MidnightLink/esphome-projects/README.md

This repo is for changes done to the Velux controller. USB-C has been added in place of the barrel plug
