MidnightLink/esphome-projects/velux-controller/pcb/velux-controller.kicad_pcb

## KiCad design velux-controller/pcb/velux-controller.kicad_pcb (2025-07-20)

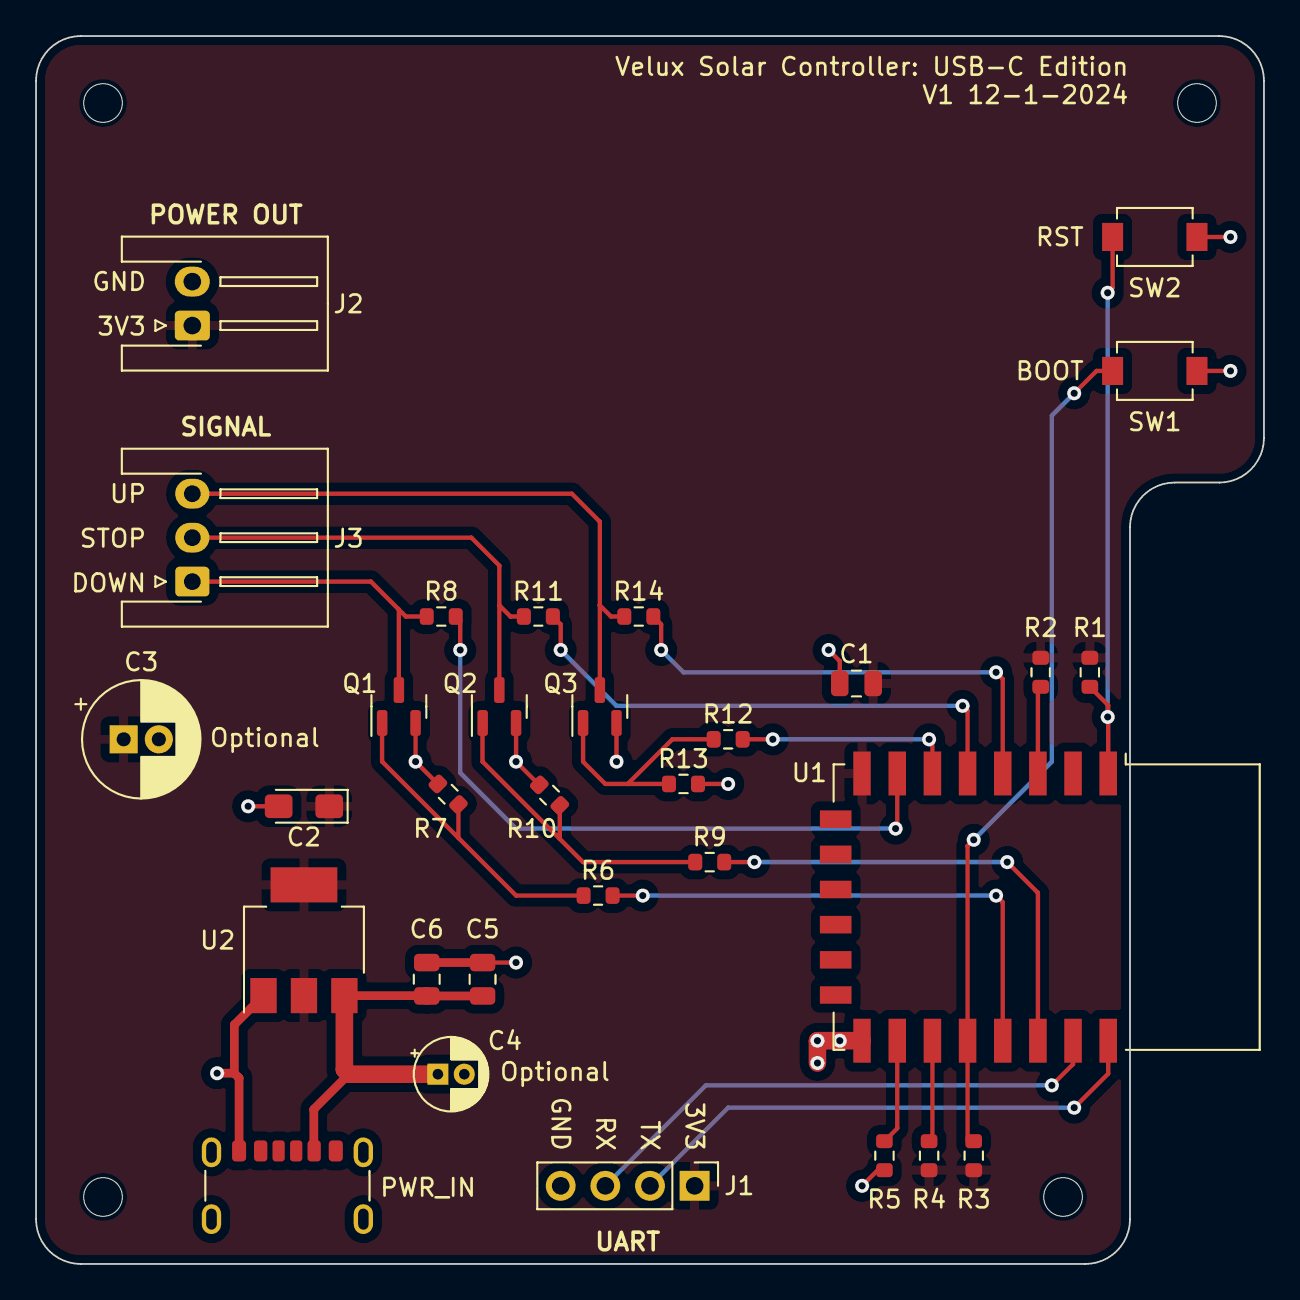
[picture p1: board velux-controller.kicad_pcb from above]

Board: 2 copper layers, 69.9 x 69.8 mm, 35 parts (0 on the bottom side), 22 nets.

Parts:
C1, C6: 0.1μF; C_0805_2012Metric
C2: 22μF; CP_EIA-3216-10_Kemet-I_Pad1.58x1.35mm_HandSolder
C3: 470μF; CP_Radial_D6.5mm_P2.00mm
C4: 10μF; CP_Radial_D4.0mm_P1.50mm
C5: 10μF; C_0805_2012Metric
H1, H2, H3, H4: MountingHole; MountingHole_2.2mm_M2
J1: UART; PinHeader_1x04_P2.54mm_Vertical
J2: POWER OUT; JST_XH_S2B-XH-A-1_1x02_P2.50mm_Horizontal
J3: SIGNAL; JST_XH_S3B-XH-A-1_1x03_P2.50mm_Horizontal
PWR_IN: USB_C_Receptacle_GCT_USB4125-xx-x_6P_TopMnt_Horiz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; USB_C_Receptacle_GCT_USB4125-xx-x_6P_TopMnt_Horizontal
Q1, Q2, Q3: MMBT3904; SOT-23
R1, R2, R3, R4, R5, R7, R10, R13: 10K; R_0603_1608Metric
R6, R8, R9, R11, R12, R14: 1K; R_0603_1608Metric
SW1: BOOT; SW_PTS820
SW2: RST; SW_PTS820
U1: ESP-12F; ESP-12E
U2: AMS1117-3.3; SOT-223-3_TabPin2

Connections:
+3.3V: C1.2, C2.1, C3.1, J1.1, J2.1, R1.2, R2.2, R3.2, R4.2, U1.8 (VCC), U2.2 (VO)
/EN: R2.1, U1.3 (EN)
/GPIO0: R3.1, SW1.2, U1.18 (GPIO0)
/GPIO2: R4.1, U1.17 (GPIO2)
/GPIO4: R6.2, U1.19 (GPIO4)
/GPIO5: R9.2, U1.20 (GPIO5)
/GPIO12: R12.2, U1.6 (GPIO12)
/GPIO13: R8.2, U1.7 (GPIO13)
/GPIO14: R11.2, U1.5 (GPIO14)
/GPIO15: R5.2, U1.16 (GPIO15)
/GPIO16: R14.2, U1.4 (GPIO16)
/LINE_DOWN: J3.1, Q1.3 (C), R8.1
/LINE_STOP: J3.2, Q2.3 (C), R11.1
/LINE_UP: J3.3, Q3.3 (C), R14.1
/RST: R1.1, SW2.2, U1.1 (~RST)
/RXD: J1.3, U1.21 (GPIO3/RXD)
/TXD: J1.2, U1.22 (GPIO1/TXD)
GND: C1.1, C2.2, C3.2, C4.2, C5.1, C6.1, J1.4, J2.2, PWR_IN.B12, Q1.2 (E), Q2.2 (E), Q3.2 (E), R5.1, R7.2, R10.2, R13.2, SW1.1, SW2.1, U1.15 (GND), U2.1 (GND)
unnamed: Q1.1 (B), R6.1, R7.1
unnamed: Q2.1 (B), R9.1, R10.1
unnamed: Q3.1 (B), R12.1, R13.1
VCC: C4.1, C5.2, C6.2, U2.3 (VI)
